DavidKHG/Spin_Coater_HW/README.md

# Spin_Coater_HW
- Final components for spin coater such as circuit, sensor, display, mechanical design.
