DavidKHG/Spin_Coater_HW/Spin_Coater_Circuit/Output/BOM/Spct_v2_0_BOM.xlsx

Id | 지정자 | 제조사 | 파트넘버 | 수량 | 값 | 풋프린트 | 비고 | 참조 링크
1 | J15,J16,J10 | CONNFLY | Single 1x8 Straight(2.54mm) | 3 | Conn_01x08 | PinSocket_1x08_P2.54mm_Vertical | 동일사양 대체품 적용 가능 | https://www.devicemart.co.kr/goods/view?no=12137
2 | J14 | CONNFLY | Single 1x10 Straight(2.54mm) | 1 | Conn_01x10 | PinSocket_1x10_P2.54mm_Vertical | 동일사양 대체품 적용 가능 | https://www.devicemart.co.kr/goods/view?no=3586
3 | R1,R7,R24,R12 | Any Vendor | 100Ω, R1608, 1%, 1/10W | 4 | 100 | R_0603_1608Metric
4 | J17 | CONNFLY | Single 1x6 Straight(2.54mm) | 1 | Conn_01x06 | PinSocket_1x06_P2.54mm_Vertical | 동일사양 대체품 적용 가능 | https://www.devicemart.co.kr/goods/view?no=12136
5 | D8 | Vishay | MMSZ5245B-E3-08 | 1 | MMSZ5245 | D_SOD-123 |  | https://www.digikey.kr/ko/products/detail/vishay-general-semiconductor-diodes-division/MMSZ5245B-E3-08/3104242
6 | R23,R20,R19 | Any Vendor | 75kΩ, R1608, 1%, 1/10W | 3 | 75k | R_0603_1608Metric
7 | L1 | Bourns | SRR6028-820Y | 1 | 22uH | L_Bourns_SRR6028 |  | https://www.digikey.kr/ko/products/detail/bourns-inc/SRR6028-820Y/1970386
8 | C5 | Any Vendor | 4.7uF, C3216, 50V, X7R | 1 | 4.7uF/50V | C_1206_3216Metric
9 | R15,R6,R13,R8 | Any Vendor | 10kΩ, R1608, 1%, 1/10W | 4 | 10k | R_0603_1608Metric
10 | R11,R5 | Any Vendor | 330Ω, R1608, 1%, 1/10W | 2 | 330 | R_0603_1608Metric
11 | U6 | Renesas Electronics | ISL85410FRZ-T | 1 | ISL85410FRZ | SON50P300X300X100-13N_270X200_ |  | https://www.digikey.kr/ko/products/detail/renesas-electronics-corporation/ISL85410FRZ-T/4519289
12 | C12,C16,C20,C18,C4,C6,C7,C3,C2 | Any Vendor | 100nF, C1608, 50V, X7R | 9 | 100nF/50V | C_0603_1608Metric
13 | Q4 | Vishay | SI7461DP-T1-GE3 | 1 | SI7461DP-T1-GE3 | PowerPAK_SO-8_Single |  | https://www.digikey.kr/ko/products/detail/vishay-siliconix/SI7461DP-T1-GE3/1995566
14 | R10 | Any Vendor | 470kΩ, R1608, 1%, 1/10W | 1 | 470k | R_0603_1608Metric
15 | D3,D6,D4 | Würth Elektronik | 150060BS55040 | 3 | 150060BS55040 | LED_0603_1608Metric |  | https://www.digikey.kr/ko/products/detail/w%C3%BCrth-elektronik/150060BS55040/8557178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
16 | D5 | onsemi | NSR20F30NXT5G | 1 | NSR20F30NXT5G | DSN2-152AB_ONS |  | https://www.digikey.kr/ko/products/detail/onsemi/NSR20F30NXT5G/2305673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
17 | R14,R26 | Any Vendor | 5.1kΩ, R1608, 1%, 1/10W | 2 | 5.1k | R_0603_1608Metric
18 | R2,R3 | Any Vendor | 1kΩ, R1608, 1%, 1/10W | 2 | 1k | R_0603_1608Metric
19 | C9 | Any Vendor | 27pF, C1608, 10V, X7R | 1 | 27pF/10V | C_0603_1608Metric
20 | C11,C19,C10,C15 | Any Vendor | 10uF, C2012, 10V, X7R | 4 | 10uF/10V | C_0805_2012Metric
21 | R21 | Any Vendor | 0Ω, R1608, 1%, 1/10W | 1 | 0 | R_0603_1608Metric
22 | R4 | Any Vendor | 330kΩ, R1608, 1%, 1/10W | 1 | 330k | R_0603_1608Metric
23 | R16,R17,R18 | Any Vendor | 4.7kΩ, R1608, 1%, 1/10W | 3 | 4.7k | R_0603_1608Metric
24 | F1 | Bel Fuse | 0679H7000-01 | 1 | 0679H7000-01 | Fuse_2410_6225_Metric |  | https://www.digikey.kr/ko/products/detail/bel-fuse-inc/0679H7000-01/6139755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
25 | R9 | Any Vendor | 10Ω, R1608, 1%, 1/10W | 1 | 10 | R_0603_1608Metric
26 | U5 | STMicroelectronics | STM32F411RET6 | 1 | STM32F411RETx | LQFP-64_10x10mm_P0.5mm | 릴/테이프 무관 | https://www.digikey.kr/ko/products/detail/stmicroelectronics/STM32F411RET6/4935722
27 | LS1 | Same Sky | CMT-7525-80-SMT-TR | 1 | CMT-7525-80-SMT-TR | XDCR_CMT-7525-80-SMT-TR |  | https://www.digikey.kr/ko/products/detail/same-sky-formerly-cui-devices/CMT-7525-80-SMT-TR/10326185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
28 | U7 | FTDI | FT231XQ | 1 | FT231XQ | QFN-20-1EP_4x4mm_P0.5mm_EP2.5x2.5mm | 릴/테이프 무관
29 | D2,D1 | Diodes Incorporated | B360B-13-F | 2 | B360B-13-F | D_SMB |  | https://www.digikey.kr/ko/products/detail/diodes-incorporated/B360B-13-F/814950
30 | C8 | Any Vendor | 1uF, C1608, 10V, X7R | 1 | 1uF/10V | C_0603_1608Metric
31 | U4 | Microchip Technology | 24LC512T-I/SN | 1 | 24LC512T-I/SN | SOIC-8_5.3x5.3mm_P1.27mm |  | https://www.digikey.kr/ko/products/detail/microchip-technology/24LC512T-I-SN/2202085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
32 | Q3,Q1 | onsemi | 2N7002ET7G | 2 | 2N7002 | SOT-23 |  | https://www.digikey.kr/ko/products/detail/onsemi/2N7002ET7G/13886993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
33 | C17 | Any Vendor | 2.2uF, C1608, 10V, X7R | 1 | 2.2uF/10V | C_0603_1608Metric
34 | C14,C13 | Any Vendor | 22uF, C2012, 10V, X7R | 2 | 22uF/10V | C_0805_2012Metric
35 | U8 | Analog Devices | ADPL42005ACPZ-3.3-R7 | 1 | ADPL42005ACPZ-3.3-R7 | LFCSP-8-1EP_3x3mm_P0.5mm_EP1.6x2.34mm |  | https://www.digikey.kr/ko/products/detail/analog-devices-inc/ADPL42005ACPZ-3-3-R7/26485210
36 | C1 | Chemi-con | EMVH500ARA331MKG5S | 1 | 330uF/50V | CP_Elec_12.5x12.5 |  | https://www.digikey.kr/ko/products/detail/chemi-con/EMVH500ARA331MKG5S/756975
37 | R25,R27 | Any Vendor | 100KΩ, R1608, 1%, 1/10W | 2 | 100k | R_0603_1608Metric
38 | J18 | G-Switch | GT-USB-7010ASV | 1 | USB_C_Receptacle_USB2.0_14P | USB_C_Receptacle_G-Switch_GT-USB-7010ASV |  | https://www.eleparts.co.kr/goods/view?no=11427952
39 | U2 | Microchip Technology | MCP4922-E/SL | 1 | MCP4922-E/SL | SOIC-14_3.9x8.7mm_P1.27mm |  | https://www.digikey.kr/ko/products/detail/microchip-technology/MCP4922-E-SL/716258
40 | J5 | JST | B4B-EH-A | 1 | EH_B4B-EH-A | JST_EH_B4B-EH-A_1x04_P2.50mm_Vertical
41 | J1 | Molex | 0039301021 (White) | 1 | Mini-Fit(5569-02A) | Molex_Mini-Fit_Jr_5569-02A2_2x01_P4.20mm_Horizontal |  | https://www.digikey.kr/ko/products/detail/molex/0039301021/561089
42 | J13 | Molex | 0430450621 (Black) | 1 | Motor_Feedback | Molex_Micro-Fit_3.0_43045-0621_2x03-1MP_P3.00mm_Horizontal |  | https://www.digikey.kr/ko/products/detail/molex/0430450621/1635025?s=N4IgTCBcDaICwGYAMcCsBaJA2MBGEAugL5A
43 | J12 | Molex | 0469990014(Black) | 1 | Motor_Output | Molex_Mini-Fit_Jr_5569-04A2_2x02_P4.20mm_Horizontal |  | https://www.digikey.kr/ko/products/detail/molex/0469990014/4553678
44 | J11 | CONNFLY | Dual 2x9 Straight(2.54mm) | 1 | Conn_02x09_Odd_Even | PinSocket_2x09_P2.54mm_Vertical |  | https://www.devicemart.co.kr/goods/view?no=12524
45 | J3 | Samtec | FTSH-105-01-L-DV-K-TR | 1 | FTSH-105-01-L-DV-K-TR | PinHeader_2x05_P1.27mm_Vertical_SMD |  | https://www.digikey.kr/ko/products/detail/samtec-inc/FTSH-105-01-L-DV/1110222
46 | J2 | JST | B3B-EH-A | 1 | EH_B3B-EH-A | JST_EH_B3B-EH-A_1x03_P2.50mm_Vertical
47 | R22 | 미삽 | 미삽 | 1 | 미삽 | R_0603_1608Metric
