DavidKHG/Spin_Coater_HW/Spin_Coater_Circuit/Output/STEP/Spct_V2_0.step

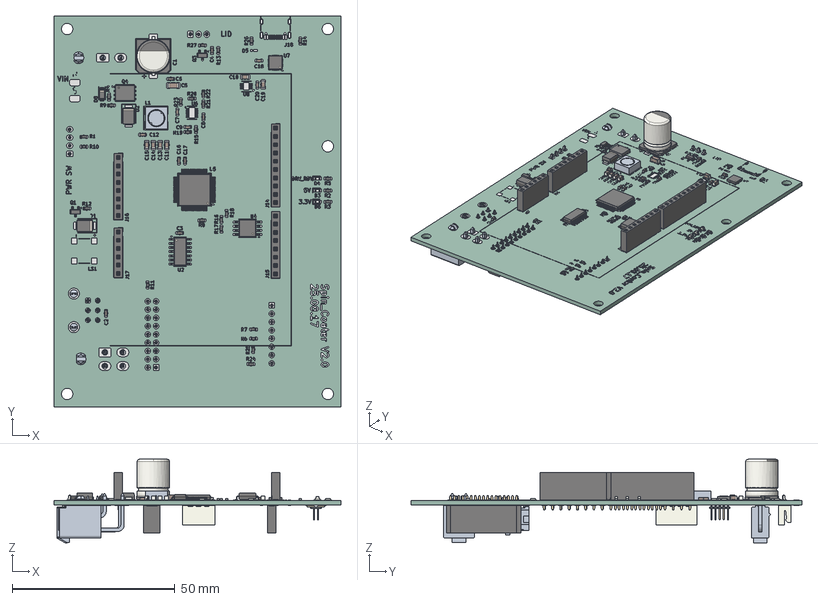
[picture p1: CAD file, 2025-08-18]
Spin_Coater_Circuit/Output/STEP/Spct_V2_0.step
88.0 x 120.0 x 25.6 mm
R_0603_1608Metric x 27
PinSocket_1x06_P2.54mm_Vertical
D_SOD-123
srr6028-180y
C_1206_3216Metric
C_0603_1608Metric x 12
LED_0603_1608Metric x 3
C_0805_2012Metric x 6
LQFP-64_10x10mm_P0.5mm
PinSocket_1x08_P2.54mm_Vertical x 3
QFN-20-1EP_4x4mm_P0.5mm_EP2.5x2.5mm
D_SMB x 2
PinSocket_1x10_P2.54mm_Vertical
SOIC-8_5.3x5.3mm_P1.27mm
SOT-23 x 2
CP_Elec_10x12.5
SOIC-14_3.9x8.7mm_P1.27mm
JST_EH_B4B-EH-A_1x04_P2.50mm_Vertical
PinSocket_2x09_P2.54mm_Vertical
PinHeader_2x05_P1.27mm_Vertical_SMD
JST_EH_B3B-EH-A_1x03_P2.50mm_Vertical
Spct_pad
Spct_silkscreen
Spct_PCB
