DavidKHG/Spin_Coater_HW/Spin_Coater_Circuit/Design_File/Spct.pdf

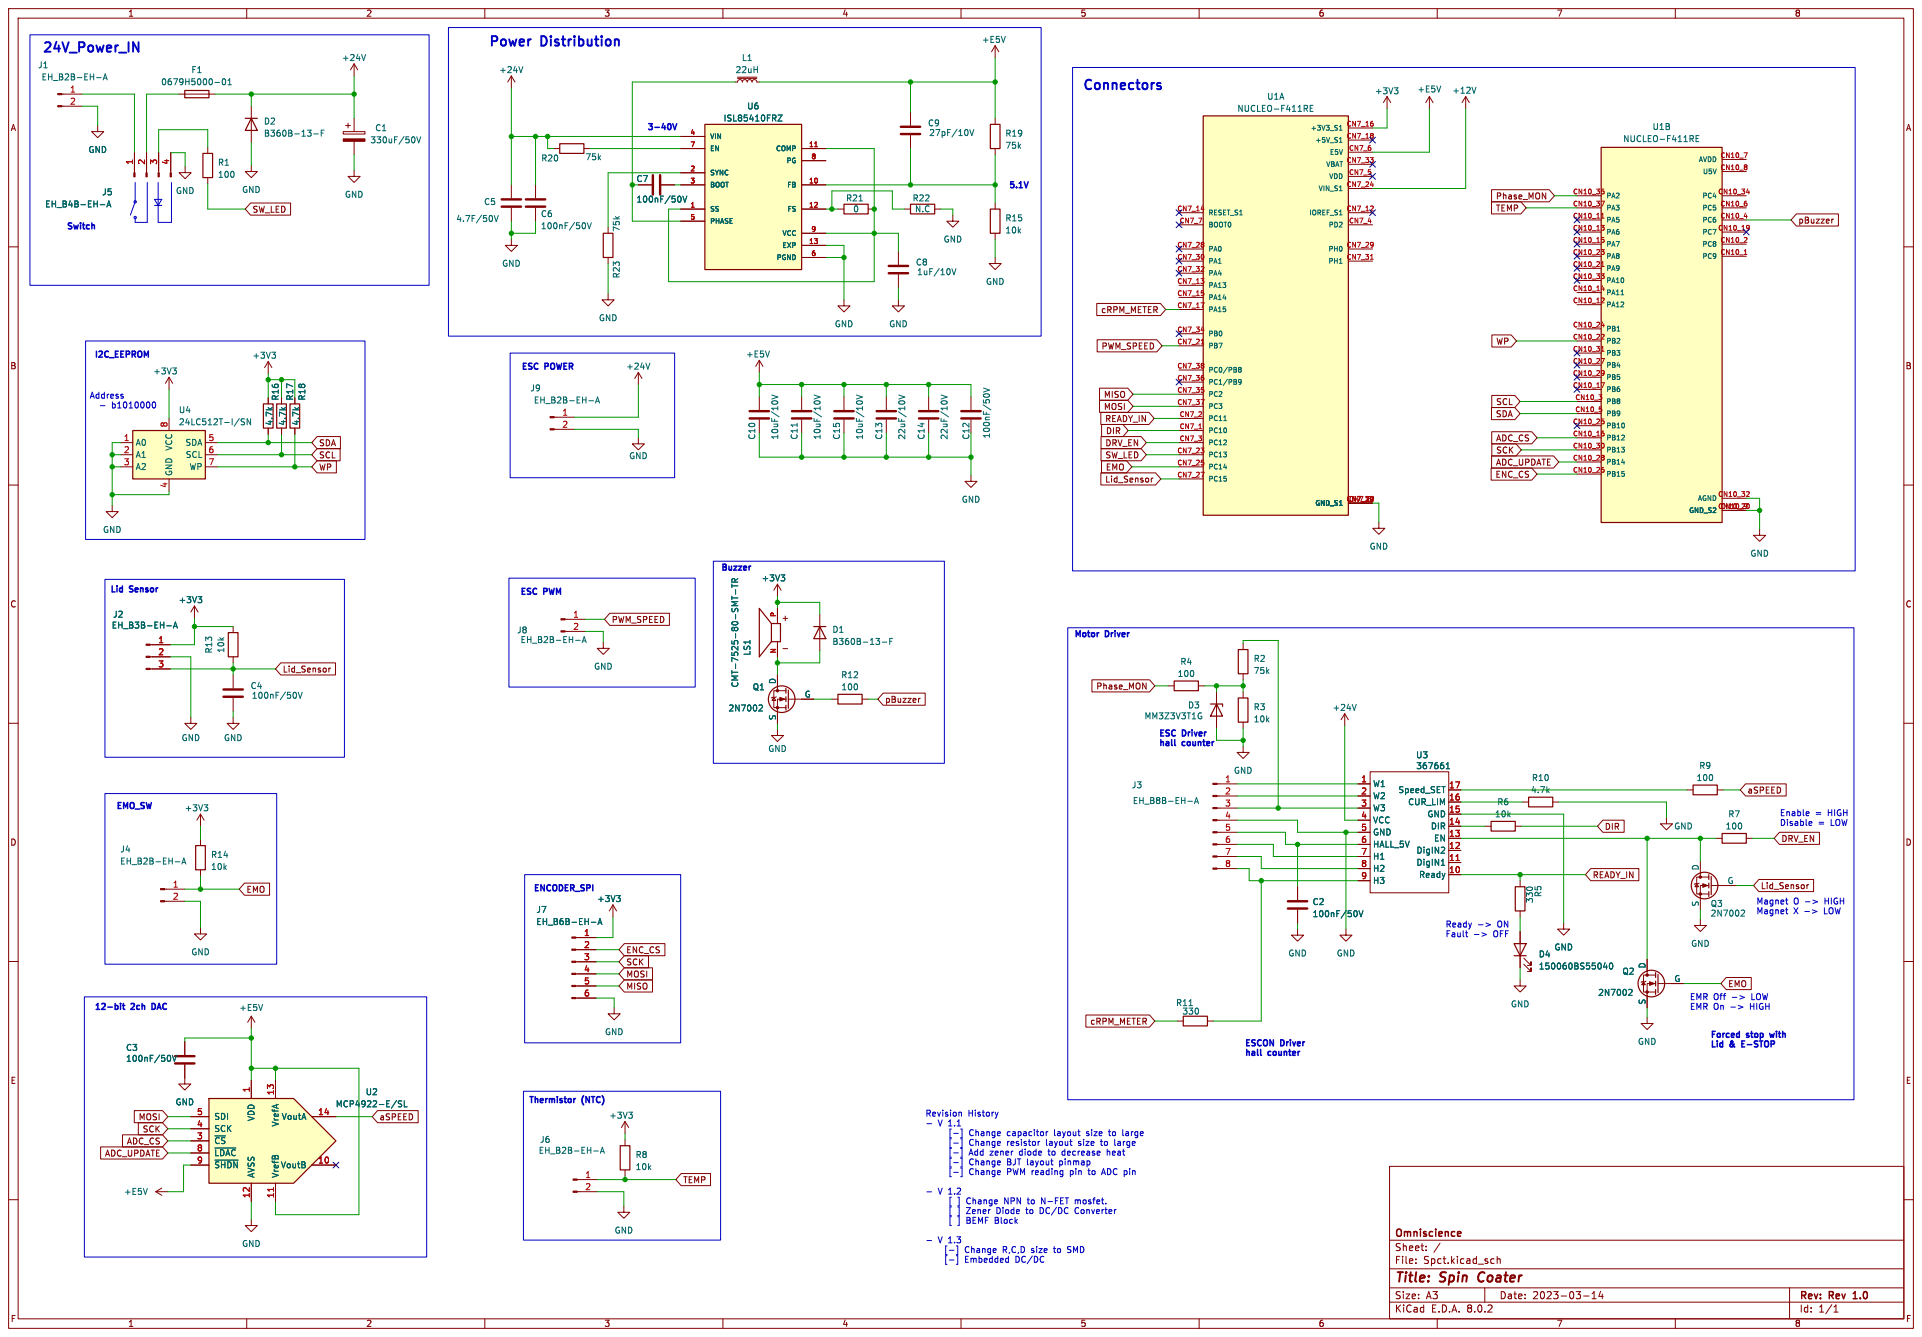
[picture p2: page 1]

S D LS1 CMT-7525-80-SMT-TR N P +3V3 GND

4 SDA 5 SCL 6 WP 7 VCC

ESCON Driver hall counter

1 VoutB 10 VrefB 11 AVSS 12 VrefA 13 VoutA 14 ~{CS} 3 SCK 4 SDI 5 ~{LDAC} 8 ~{SHDN} 9 C3
100nF/50V GND

1 VoutB 10 VrefB 11 AVSS 12 VrefA 13 VoutA 14 ~{CS} 3 SCK 4 SDI 5 ~{LDAC} 8 ~{SHDN} 9 U2 MCP4922-E/SL

Id: 1/1 Title: Spin Coater File: Spct.kicad_sch Sheet: / Omniscience
