DavidKHG/Spin_Coater_HW/Spin_Coater_Circuit/Output/Schematics/Spct_V2_0.pdf

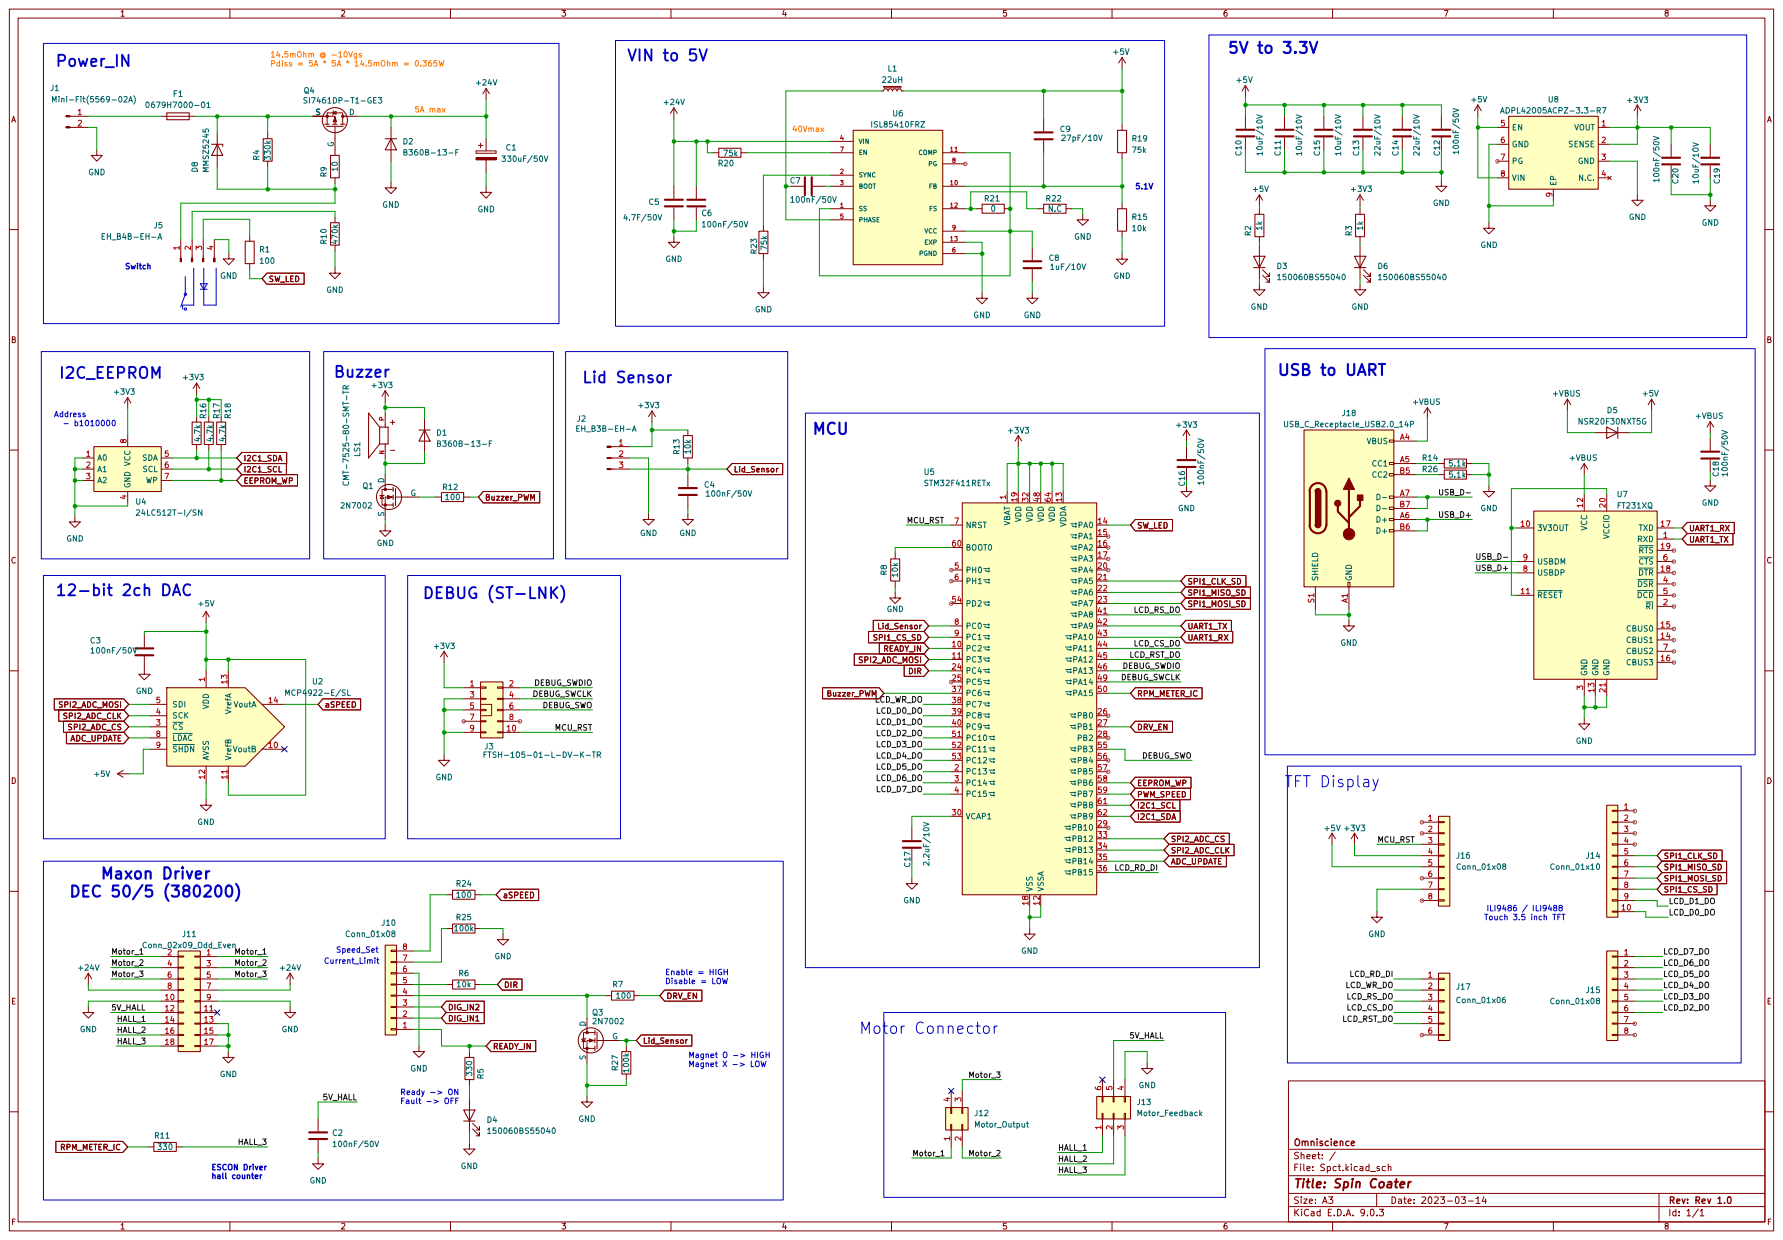
[picture p3: page 1]
