DavidKHG/Spin_Coater_HW/Spin_Coater_Circuit/Design_File/Spct.kicad_pcb

## KiCad design Spin_Coater_Circuit/Design_File/Spct.kicad_pcb (2025-08-18)

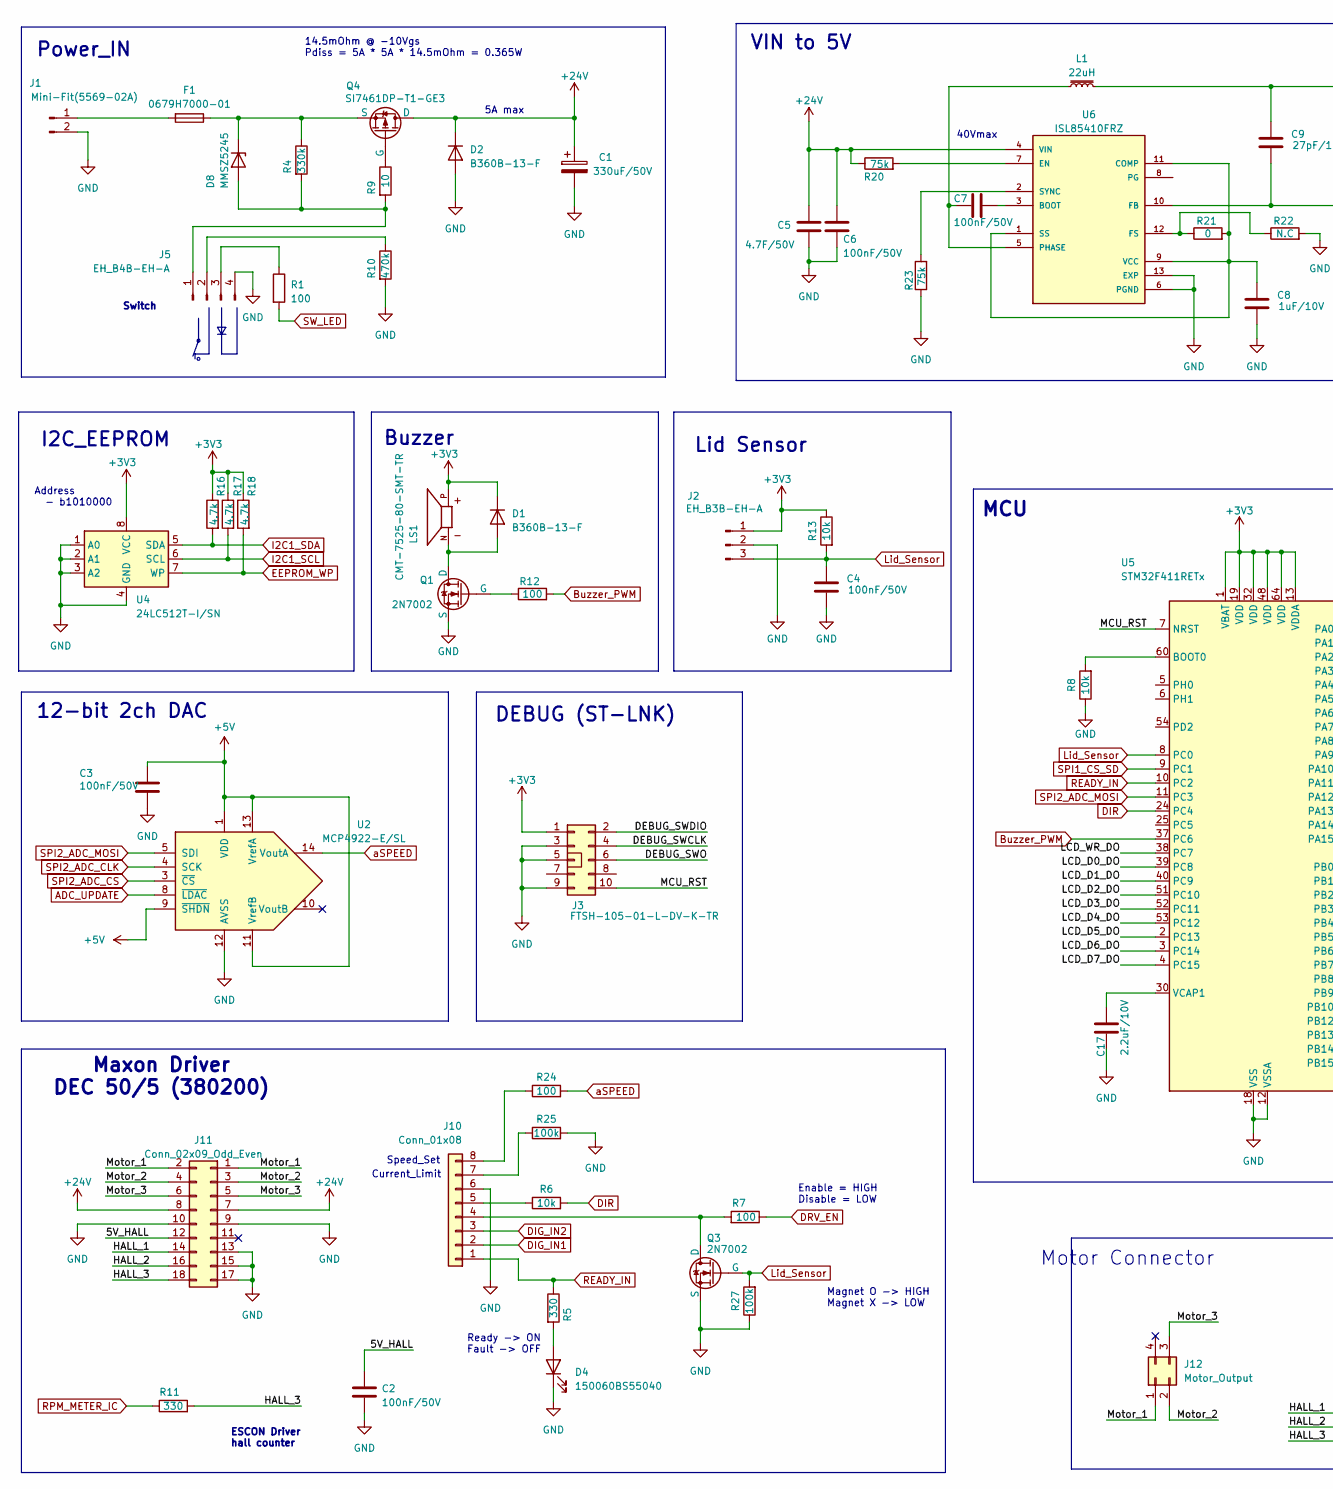
[picture p4: schematic Spct.kicad_sch, Spin Coater, part in row 1, column 1]

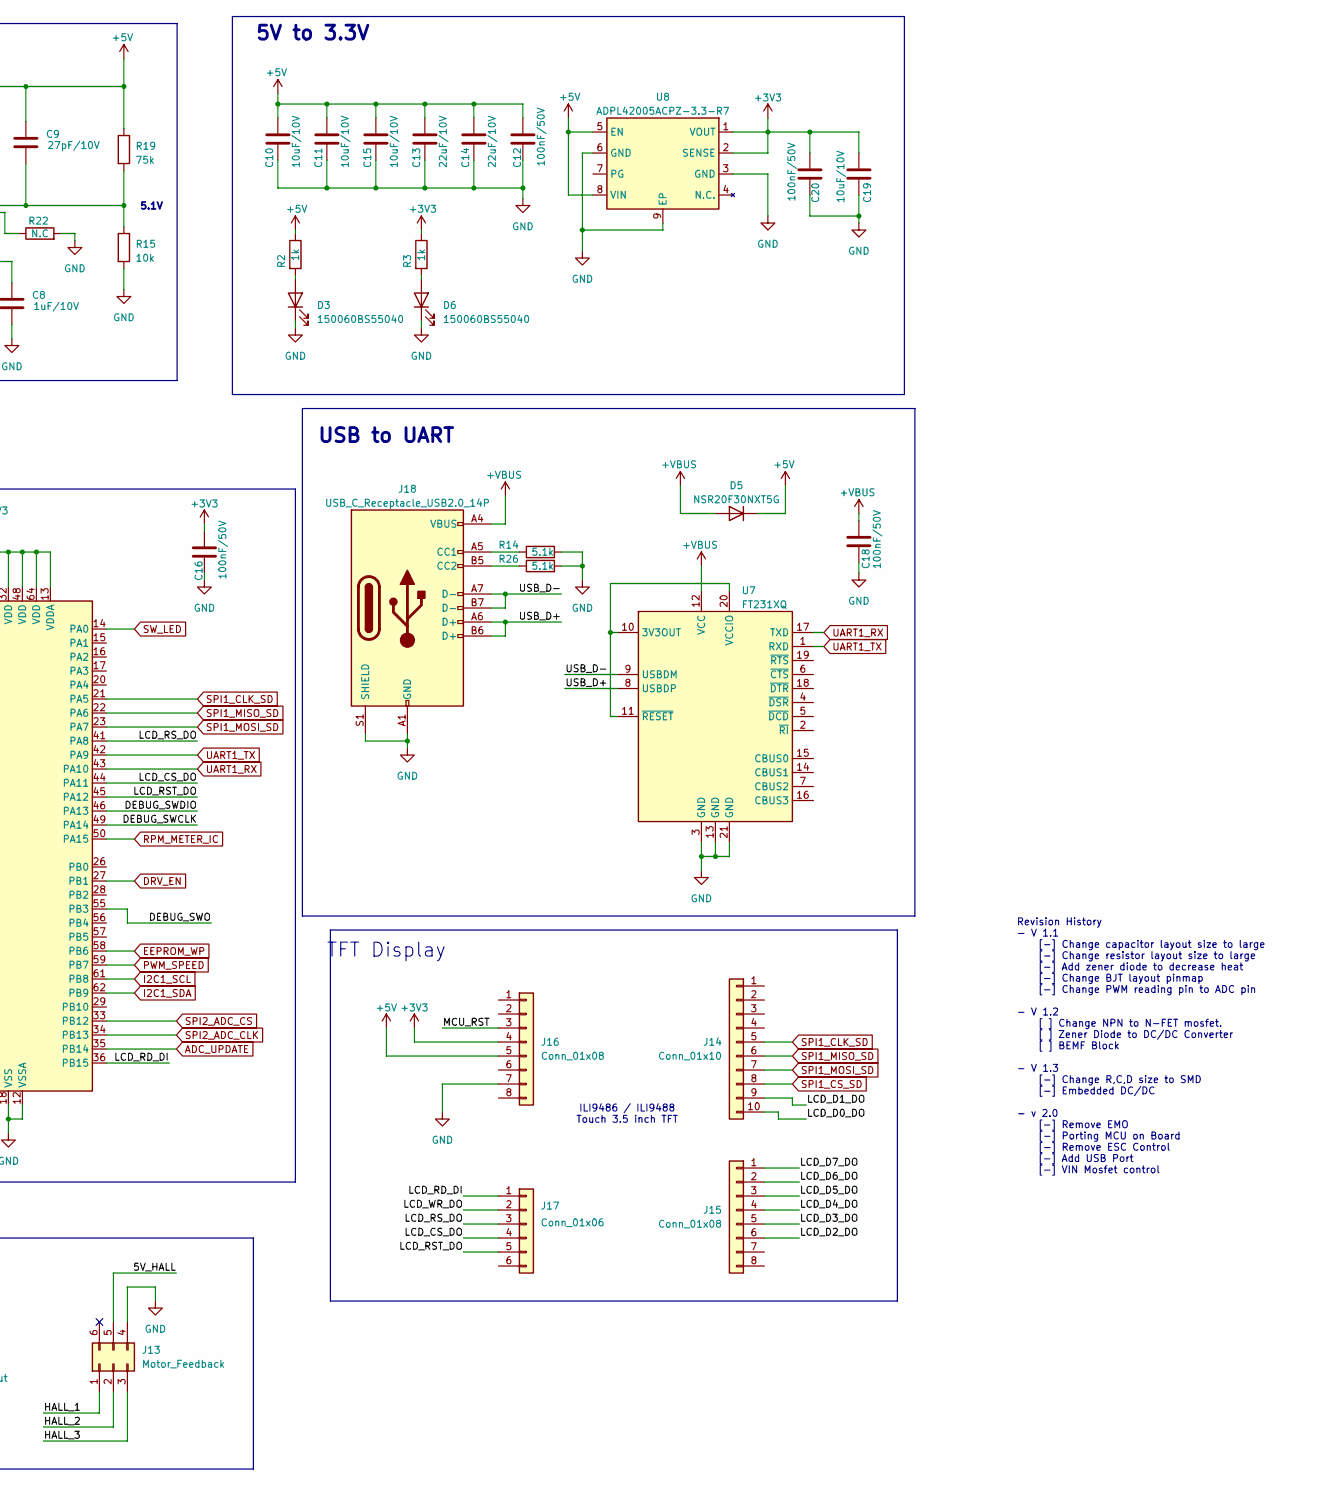
[picture p5: schematic Spct.kicad_sch, Spin Coater, part in row 1, column 2]

Parts:
C1: 330uF/50V; CP_Elec_12.5x12.5
C2, C3, C4, C6, C7, C12, C16, C18, C20: 100nF/50V; C_0603_1608Metric
C5: 4.7F/50V; C_1206_3216Metric
C8: 1uF/10V; C_0603_1608Metric
C9: 27pF/10V; C_0603_1608Metric
C10, C11, C15, C19: 10uF/10V; C_0805_2012Metric
C13, C14: 22uF/10V; C_0805_2012Metric
C17: 2.2uF/10V; C_0603_1608Metric
D1, D2: B360B-13-F; D_SMB
D3, D4, D6: 150060BS55040; LED_0603_1608Metric
D5: NSR20F30NXT5G; DSN2-152AB_ONS
D8: MMSZ5245; D_SOD-123
F1: 0679H7000-01; Fuse_2410_6225_Metric
J1: Mini-Fit(5569-02A); Molex_Mini-Fit_Jr_5569-02A2_2x01_P4.20mm_Horizontal
J2: EH_B3B-EH-A; JST_EH_B3B-EH-A_1x03_P2.50mm_Vertical
J3: FTSH-105-01-L-DV-K-TR; PinHeader_2x05_P1.27mm_Vertical_SMD
J5: EH_B4B-EH-A; JST_EH_B4B-EH-A_1x04_P2.50mm_Vertical
J10, J15, J16: Conn_01x08; PinSocket_1x08_P2.54mm_Vertical
J11: Conn_02x09_Odd_Even; PinSocket_2x09_P2.54mm_Vertical
J12: Motor_Output; Molex_Mini-Fit_Jr_5569-04A2_2x02_P4.20mm_Horizontal
J13: Motor_Feedback; Molex_Micro-Fit_3.0_43045-0621_2x03-1MP_P3.00mm_Horizontal
J14: Conn_01x10; PinSocket_1x10_P2.54mm_Vertical
J17: Conn_01x06; PinSocket_1x06_P2.54mm_Vertical
J18: USB_C_Receptacle_USB2.0_14P; USB_C_Receptacle_G-Switch_GT-USB-7010ASV
L1: 22uH; L_Bourns_SRR6028
LS1: CMT-7525-80-SMT-TR; XDCR_CMT-7525-80-SMT-TR; PARTREV N/A
Q1, Q3: 2N7002; SOT-23
Q4: SI7461DP-T1-GE3; PowerPAK_SO-8_Single
R1, R7, R12, R24: 100; R_0603_1608Metric
R2, R3: 1k; R_0603_1608Metric
R4: 330k; R_0603_1608Metric
R5, R11: 330; R_0603_1608Metric
R6, R8, R13, R15: 10k; R_0603_1608Metric
R9: 10; R_0603_1608Metric
R10: 470k; R_0603_1608Metric
R14, R26: 5.1k; R_0603_1608Metric
R16, R17, R18: 4.7k; R_0603_1608Metric
R19, R20, R23: 75k; R_0603_1608Metric
R21: 0; R_0603_1608Metric
R22: N.C; R_0603_1608Metric
R25, R27: 100k; R_0603_1608Metric
U2: MCP4922-E/SL; SOIC-14_3.9x8.7mm_P1.27mm
U4: 24LC512T-I/SN; SOIC-8_5.3x5.3mm_P1.27mm
U5: STM32F411RETx; LQFP-64_10x10mm_P0.5mm
U6: ISL85410FRZ; SON50P300X300X100-13N_270X200_; PARTREV 8.00
U7: FT231XQ; QFN-20-1EP_4x4mm_P0.5mm_EP2.5x2.5mm
U8: ADPL42005ACPZ-3.3-R7; LFCSP-8-1EP_3x3mm_P0.5mm_EP1.6x2.34mm

Connections:
+3V3: C16.1, C19.1, C20.1, D1.1 (K), J2.1, J3.1, J16.4, LS1.P, R3.1, R13.1, R16.1, R17.1, R18.1, U4.8 (VCC), U5.1 (VBAT), U5.13 (VDDA), U5.19 (VDD), U5.32 (VDD), U5.48 (VDD), U5.64 (VDD), U8.1 (VOUT), U8.2 (SENSE)
+5V: C3.1, C9.1, C10.1, C11.1, C12.1, C13.1, C14.1, C15.1, D5.1 (K), J16.5, L1.2, R2.1, R19.1, U2.1 (VDD), U2.9 (~SHDN), U2.11 (VrefB), U2.13 (VrefA), U8.5 (EN), U8.8 (VIN)
+24V: C1.1, C5.1, C6.1, D2.1 (K), J11.7, J11.8, Q4.5 (D), R20.1, U6.4 (VIN)
+VBUS: C18.1, D5.2 (A), J18.A4 (VBUS), J18.A9 (VBUS), J18.B4 (VBUS), J18.B9 (VBUS), U7.12 (VCC)
/5V_HALL: C2.1, J11.12, J13.5
/DEBUG_SWCLK: J3.4, U5.49 (PA14)
/DEBUG_SWDIO: J3.2, U5.46 (PA13)
/DEBUG_SWO: J3.6, U5.55 (PB3)
/HALL_1: J11.14, J13.1
/HALL_2: J11.16, J13.2
/HALL_3: J11.18, J13.3, R11.2
/LCD_CS_DO: J17.4, U5.44 (PA11)
/LCD_D0_DO: J14.10, U5.39 (PC8)
/LCD_D1_DO: J14.9, U5.40 (PC9)
/LCD_D2_DO: J15.6, U5.51 (PC10)
/LCD_D3_DO: J15.5, U5.52 (PC11)
/LCD_D4_DO: J15.4, U5.53 (PC12)
/LCD_D5_DO: J15.3, U5.2 (PC13)
/LCD_D6_DO: J15.2, U5.3 (PC14)
/LCD_D7_DO: J15.1, U5.4 (PC15)
/LCD_RD_DI: J17.1, U5.36 (PB15)
/LCD_RST_DO: J17.5, U5.45 (PA12)
/LCD_RS_DO: J17.3, U5.41 (PA8)
/LCD_WR_DO: J17.2, U5.38 (PC7)
/MCU_RST: J3.10, J16.3, U5.7 (NRST)
/Motor_1: J11.1, J11.2, J12.1
/Motor_2: J11.3, J11.4, J12.2
/Motor_3: J11.5, J11.6, J12.3
/USB_D+: J18.A6 (D+), J18.B6 (D+), U7.8 (USBDP)
/USB_D-: J18.A7 (D-), J18.B7 (D-), U7.9 (USBDM)
ADC_UPDATE: U2.8 (~LDAC), U5.35 (PB14)
Buzzer_PWM: R12.2, U5.37 (PC6)
DIG_IN1: J10.2
DIG_IN2: J10.3
DIR: R6.2, U5.24 (PC4)
DRV_EN: R7.1, U5.27 (PB1)
EEPROM_WP: R18.2, U4.7 (WP), U5.58 (PB6)
GND: C1.2, C2.2, C3.2, C4.2, C5.2, C6.2, C8.2, C10.2, C11.2, C12.2, C13.2, C14.2, C15.2, C16.2, C17.2, C18.2, C19.2, C20.2, D2.2 (A), D3.1 (K), D4.1 (K), D6.1 (K), J1.2, J2.2, J3.3, J3.5, J3.9, J5.4, J10.6, J11.9, J11.10, J11.13, J11.15, J11.17, J13.4, J16.7, J18.A1 (GND), J18.A12 (GND), J18.B1 (GND), J18.B12 (GND), J18.S1 (SHIELD), Q1.2 (S), Q3.2 (S), R8.1, R10.2, R14.2, R15.2, R22.2, R23.1, R25.2, R26.2, R27.1, U2.12 (AVSS), U4.1 (A0), U4.2 (A1), U4.3 (A2), U4.4 (GND), U5.12 (VSSA), U5.18 (VSS), U5.31 (VSS), U5.47 (VSS), U5.63 (VSS), U6.6 (PGND), U6.13 (EXP), U7.3 (GND), U7.13 (GND), U7.21 (GND), U8.3 (GND), U8.6 (GND), U8.9 (EP)
I2C1_SCL: R17.2, U4.6 (SCL), U5.61 (PB8)
I2C1_SDA: R16.2, U4.5 (SDA), U5.62 (PB9)
Lid_Sensor: C4.1, J2.3, Q3.1 (G), R13.2, R27.2, U5.8 (PC0)
unnamed: D1.2 (A), LS1.N, Q1.3 (D)
unnamed: D3.2 (A), R2.2
unnamed: D4.2 (A), R5.2
unnamed: D6.2 (A), R3.2
unnamed: D8.2 (A), J5.1, R4.2, R9.2
unnamed: D8.1 (K), F1.1, Q4.1 (S), Q4.2 (S), Q4.3 (S), R4.1
unnamed: F1.2, J1.1
unnamed: J5.2, R10.1
unnamed: J5.3, R1.1
unnamed: J10.4, Q3.3 (D), R7.2
unnamed: J10.5, R6.1
unnamed: J10.7, R25.1
unnamed: J10.8, R24.1
unnamed: J18.A5 (CC1), R14.1
unnamed: J18.B5 (CC2), R26.1
unnamed: Q1.1 (G), R12.1
unnamed: Q4.4 (G), R9.1
unnamed: R8.2, U5.60 (BOOT0)
unnamed: C17.1, U5.30 (VCAP1)
unnamed: C7.1, U6.3 (BOOT)
unnamed: C8.1, R21.2, U6.1 (SS), U6.9 (VCC), U6.11 (COMP)
unnamed: R20.2, U6.7 (EN)
unnamed: C9.2, R15.1, R19.2, U6.10 (FB)
unnamed: R21.1, R22.1, U6.12 (FS)
unnamed: C7.2, L1.1, U6.5 (PHASE)
unnamed: R23.2, U6.2 (SYNC)
unnamed: U7.10 (3V3OUT), U7.11 (~RESET), U7.20 (VCCIO)
PWM_SPEED: U5.59 (PB7)
READY_IN: J10.1, R5.1, U5.10 (PC2)
RPM_METER_IC: R11.1, U5.50 (PA15)
SPI1_CLK_SD: J14.5, U5.21 (PA5)
SPI1_CS_SD: J14.8, U5.9 (PC1)
SPI1_MISO_SD: J14.6, U5.22 (PA6)
SPI1_MOSI_SD: J14.7, U5.23 (PA7)
SPI2_ADC_CLK: U2.4 (SCK), U5.34 (PB13)
SPI2_ADC_CS: U2.3 (~CS), U5.33 (PB12)
SPI2_ADC_MOSI: U2.5 (SDI), U5.11 (PC3)
SW_LED: R1.2, U5.14 (PA0)
UART1_RX: U5.43 (PA10), U7.17 (TXD)
UART1_TX: U5.42 (PA9), U7.1 (RXD)
aSPEED: R24.2, U2.14 (VoutA)

Notes on the sheet:
Maxon Driver DEC 50/5 (380200)
40Vmax
Buzzer
Lid Sensor
12-bit 2ch DAC
ESCON Driver hall counter
Address - b1010000
Power_IN
I2C_EEPROM
Speed_Set
USB to UART
MCU
Current_Limit
5V to 3.3V
Revision History - V 1.1 [-] Change capacitor layout size to large [-] Change resistor layout size to large [-] Add zener diode to decrease heat [-] Change BJT layout pinmap [-] Change PWM reading pin to ADC pin - V 1.2 [ ] Change NPN to N-FET mosfet. [ ] Zener Diode to DC/DC Converter [ ] BEMF Blo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
Ready -> ON Fault -> OFF
5A max
Motor Connector
Enable = HIGH Disable = LOW
5.1V
Magnet O -> HIGH Magnet X -> LOW
DEBUG (ST-LNK)
TFT Display
Switch
14.5mOhm @ -10Vgs Pdiss = 5A * 5A * 14.5mOhm = 0.365W
ILI9486 / ILI9488 Touch 3.5 inch TFT
VIN to 5V

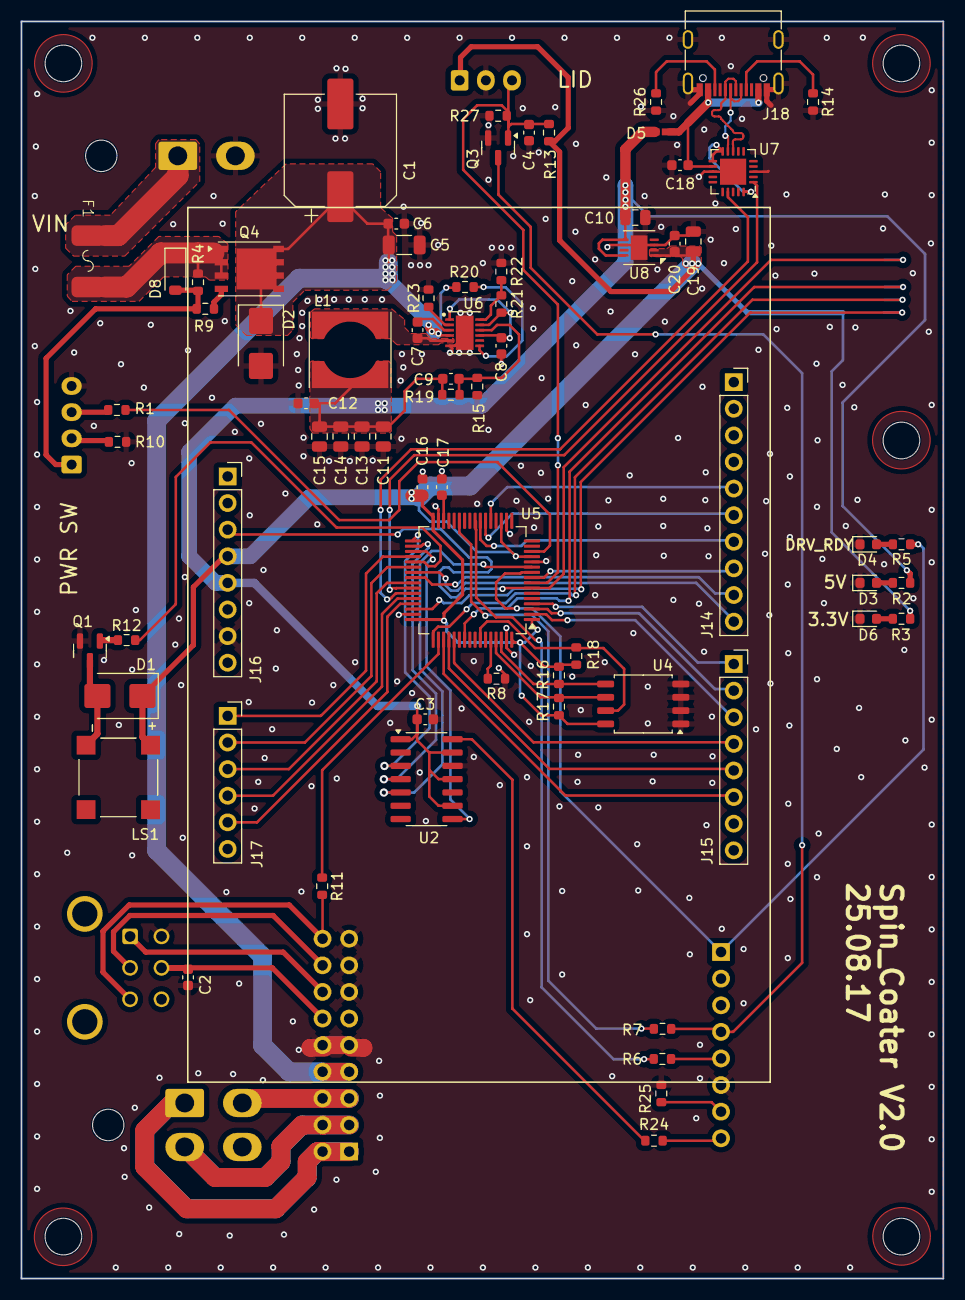
[picture p6: board Spct.kicad_pcb from above]

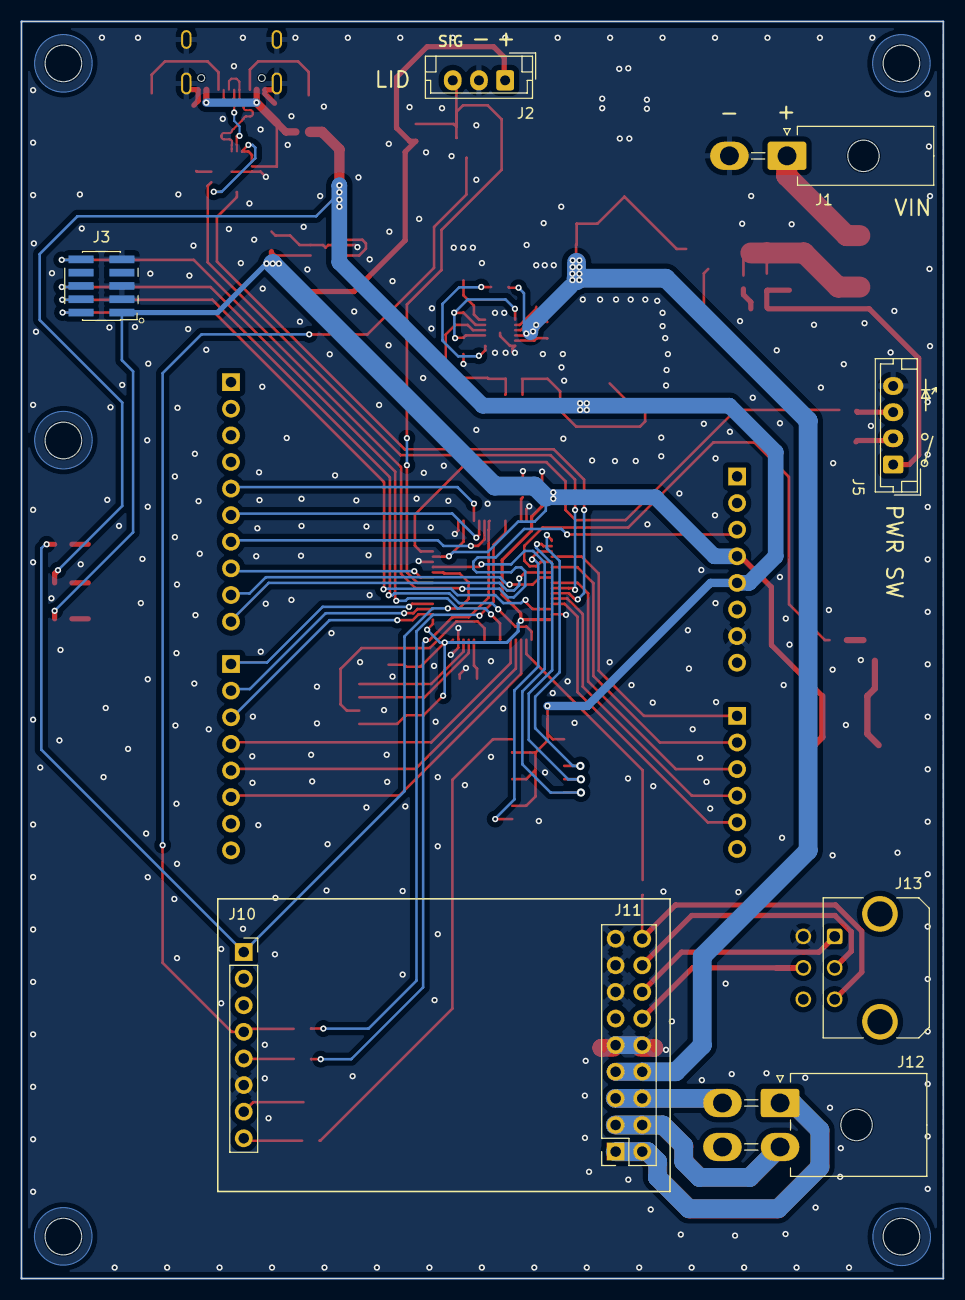
[picture p7: board Spct.kicad_pcb from below]

Board: 2 copper layers, 88.0 x 120.0 mm, 79 parts (8 on the bottom side), 79 nets.
