DavidKHG/Spin_Coater_HW/(threads)

Thread 1 (2024-06-26):

Lid Sensor logic 변경에 따른 회로 수정

DavidKHG, 2024-06-26:
### Lid Sensor
- 기존 센서는 Active Low 구성이었으나, 기성품으로 판매되는 센서는 Active High
- 현재 회로 상, BJT를 통해 물리적으로 모터 Enable에 물려있어서 Logic이 바뀌면 모터 구동마저 뒤집힘.

### Solution
- 물리적 BJT 연결을 제거하고, MCU에서 동작을 판단하도록 구성
- F/W상 Lid Open 로직을 뒤입어 설정
