DavidKHG/Spin_Coater_HW/(commit log)

2023-06-29 Circuit Design ver 1.0
    [Spct-B_Cu.gbr, Spct-B_Mask.gbr, Spct-B_Paste.gbr, Spct-B_Silkscreen.gbr, Spct-Edge_Cuts.gbr, Spct-F_Cu.gbr, Spct-F_Mask.gbr, Spct-F_Paste.gbr]
2023-07-01 Change Ver1.1
    [Spct.kicad_pcb, Spct.kicad_sch, Spct_BOM.xlsx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]
2023-07-01 add schematics print
    [Spct_BOM.xlsx]
2023-07-01 modify gitignore for ki-cad
2023-07-28 Circuit version 1.2
    [Spct-B_Cu.gbr, Spct-B_Fab.gbr, Spct-B_Mask.gbr, Spct-B_Paste.gbr, Spct-B_Silkscreen.gbr, Spct-Edge_Cuts.gbr, Spct-F_Cu.gbr, Spct-F_Fab.gbr]
2024-05-19 Spin coater ver1.3
    [Spct-B_Cu.gbr, Spct-B_Fab.gbr, Spct-B_Mask.gbr, Spct-B_Paste.gbr, Spct-B_Silkscreen.gbr, Spct-Edge_Cuts.gbr, Spct-F_Cu.gbr, Spct-F_Fab.gbr]
2025-08-03 version 2.0 circuit init
    [Spct.kicad_sch]
2025-08-11 Place Arduino pinout / Drv socket
    [Spct.kicad_pcb, Spct.kicad_sch]
2025-08-17 finalize layout
    [Spct.kicad_pcb, Spct.kicad_sch]
2025-08-18 Output setup & layout minor fix
    [Spct-B_Cu.gbr, Spct-B_Fab.gbr, Spct-B_Mask.gbr, Spct-B_Paste.gbr, Spct-B_Silkscreen.gbr, Spct-Edge_Cuts.gbr, Spct-F_Cu.gbr, Spct-F_Fab.gbr]
2025-08-22 modify final output
    [Spct.kicad_sch, Spct_v2_0_BOM.xlsx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]
